unsword01/AnyTone-AT779-Mic-Serial/AT-779UV_Arduino_PTT_Schematic.pdf

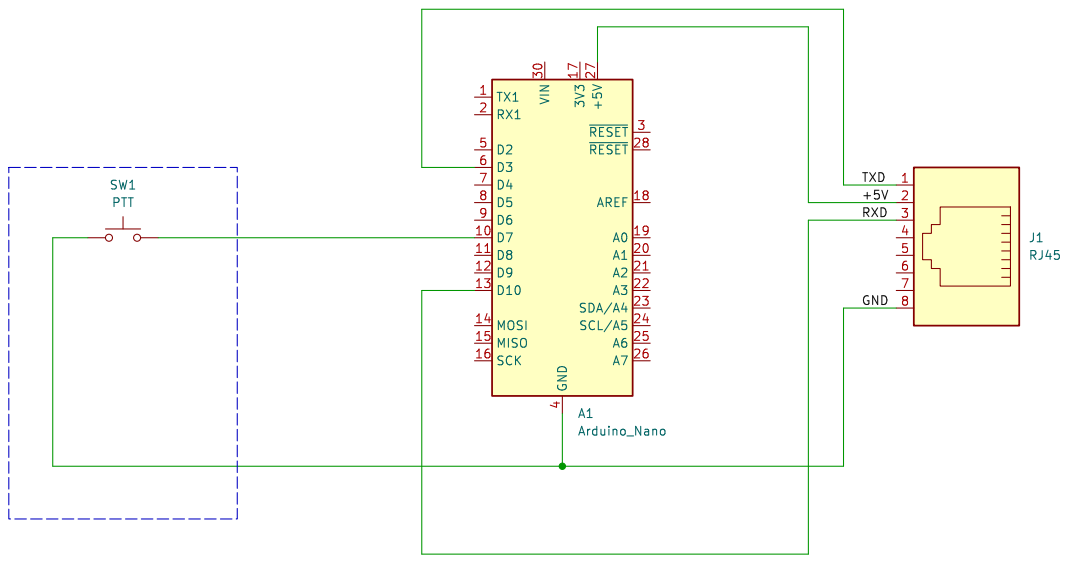
[picture p1: page 1]

Id: 1/1 Title: File: AT-779UV_Arduino_PTT_v2.kicad_sch Sheet: /
