unsword01/AnyTone-AT779-Mic-Serial/(commit log)

2025-06-17 Added Schematic
2025-06-17 Revised Schematic
2025-06-17 Schematic plot output
2025-06-21 Updated Switch Type
